darzizalol/eg1311-project/Matlab/Wheel Radius - Wheel Gap - Mass - Finish Time.png

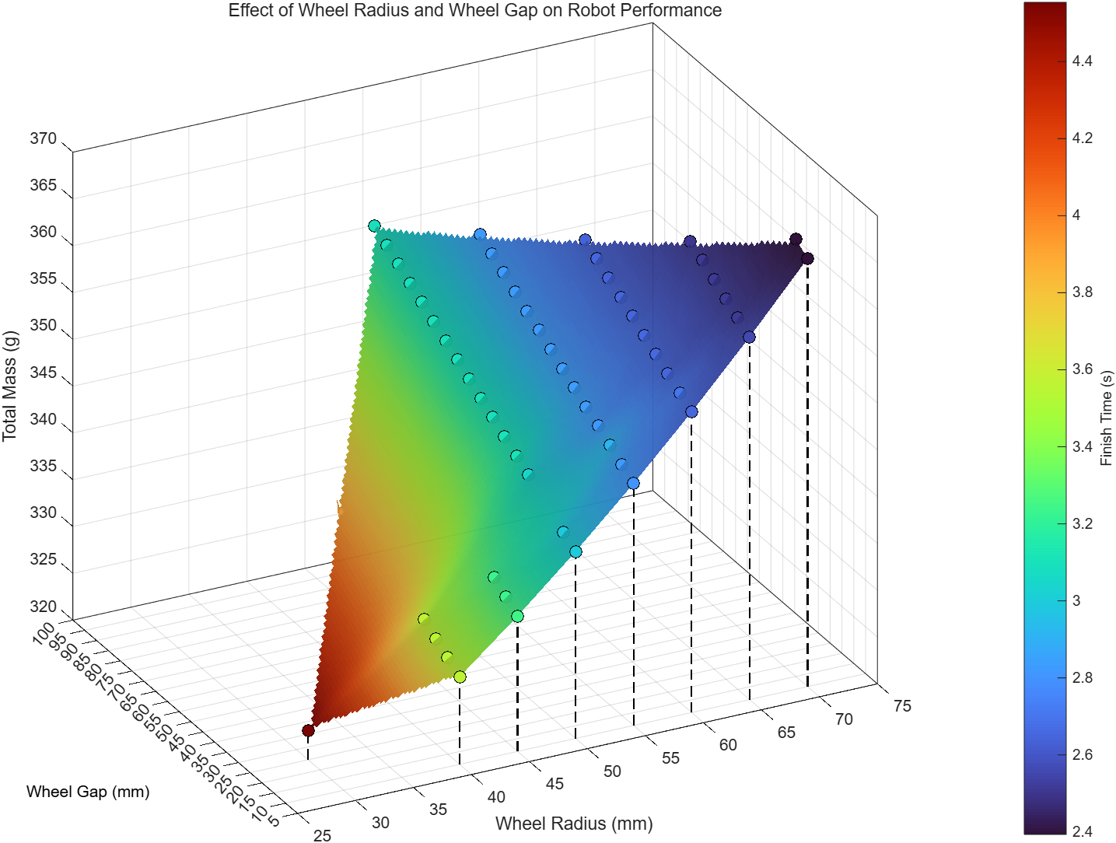
Matlab/Wheel Radius - Wheel Gap - Mass - Finish Time.png
