darzizalol/eg1311-project/Fusion360/Ping Pang Box Methods.md

Method 1: Masu Box
https://in.pinterest.com/pin/652670171034580377/

Method 2: Strong Box
https://www.youtube.com/watch?v=Zg081nhLKPg

√ Method 3: storage box
https://www.bilibili.com/video/BV1s34y1m7d1/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
