darzizalol/eg1311-project/2D CAD Drawings/Ball Basket Drawing.png

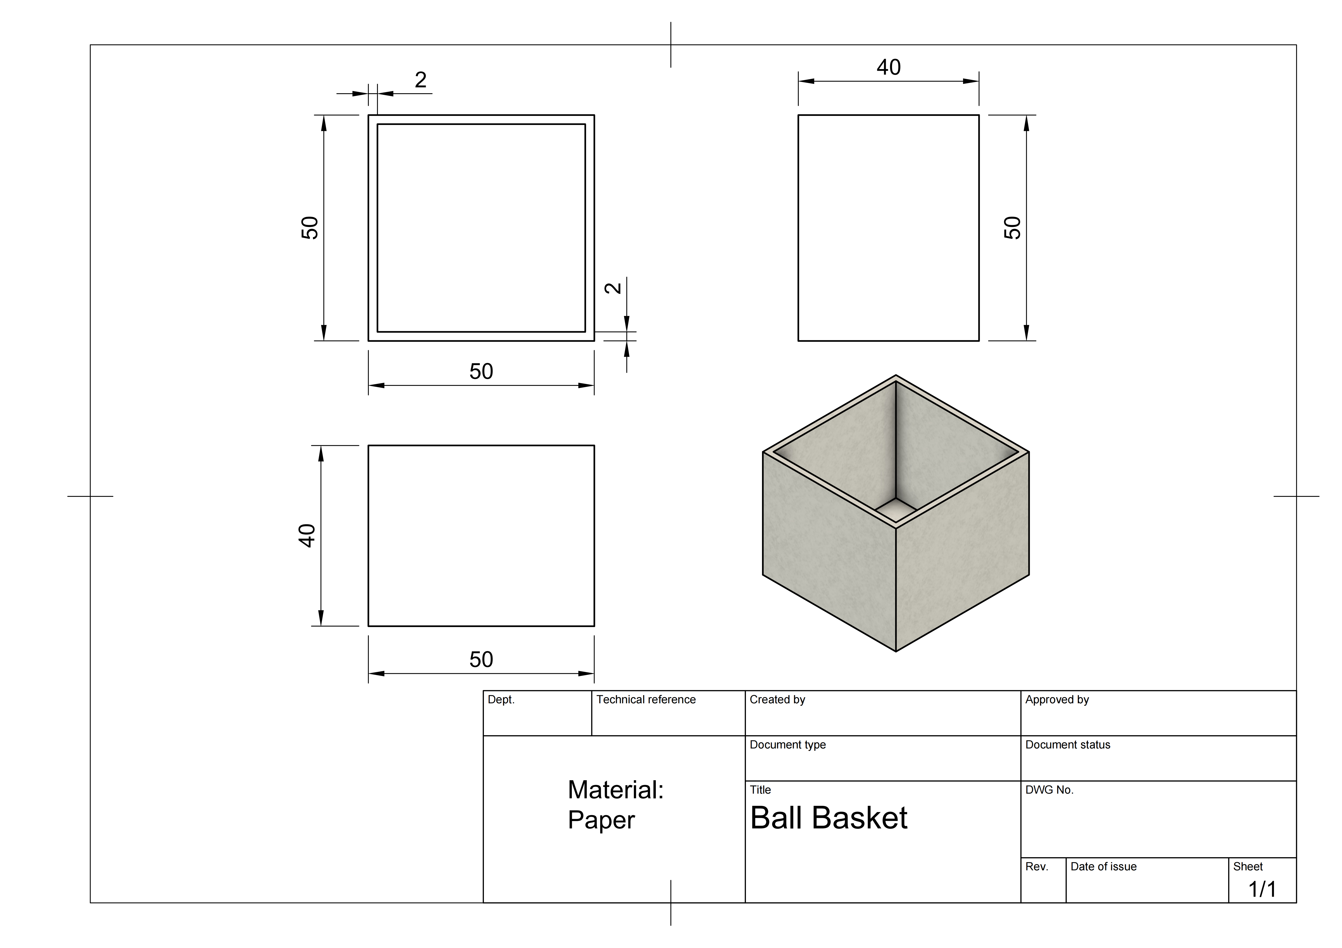
2D CAD Drawings/Ball Basket Drawing.png
