darzizalol/eg1311-project/2D CAD Drawings/Body Drawing.png

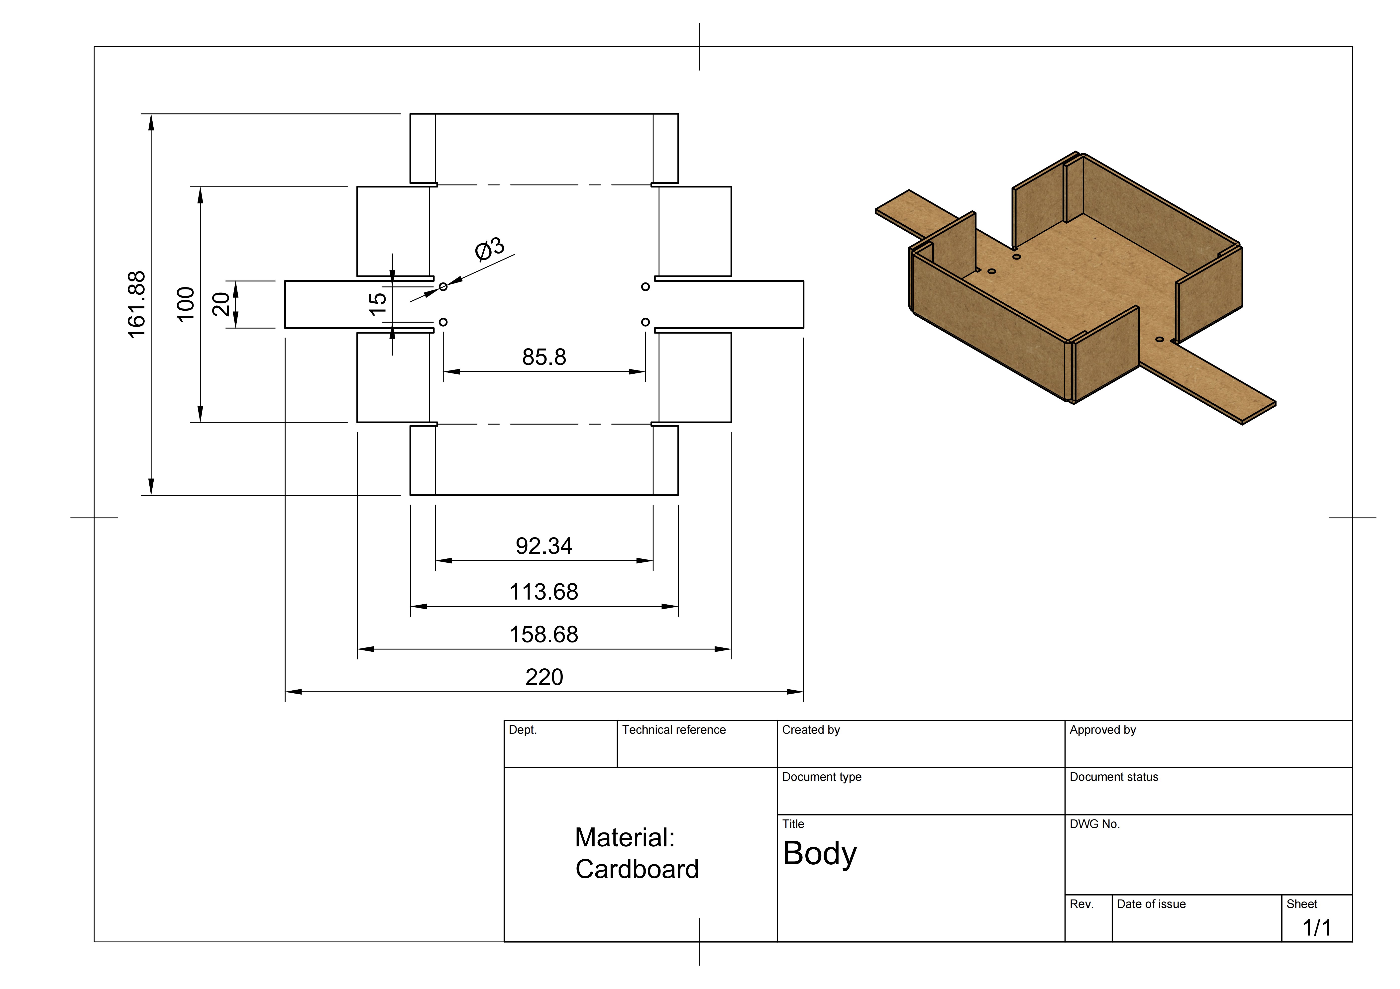
2D CAD Drawings/Body Drawing.png
