darzizalol/eg1311-project/2D CAD Drawings/Wheel Drawing.png

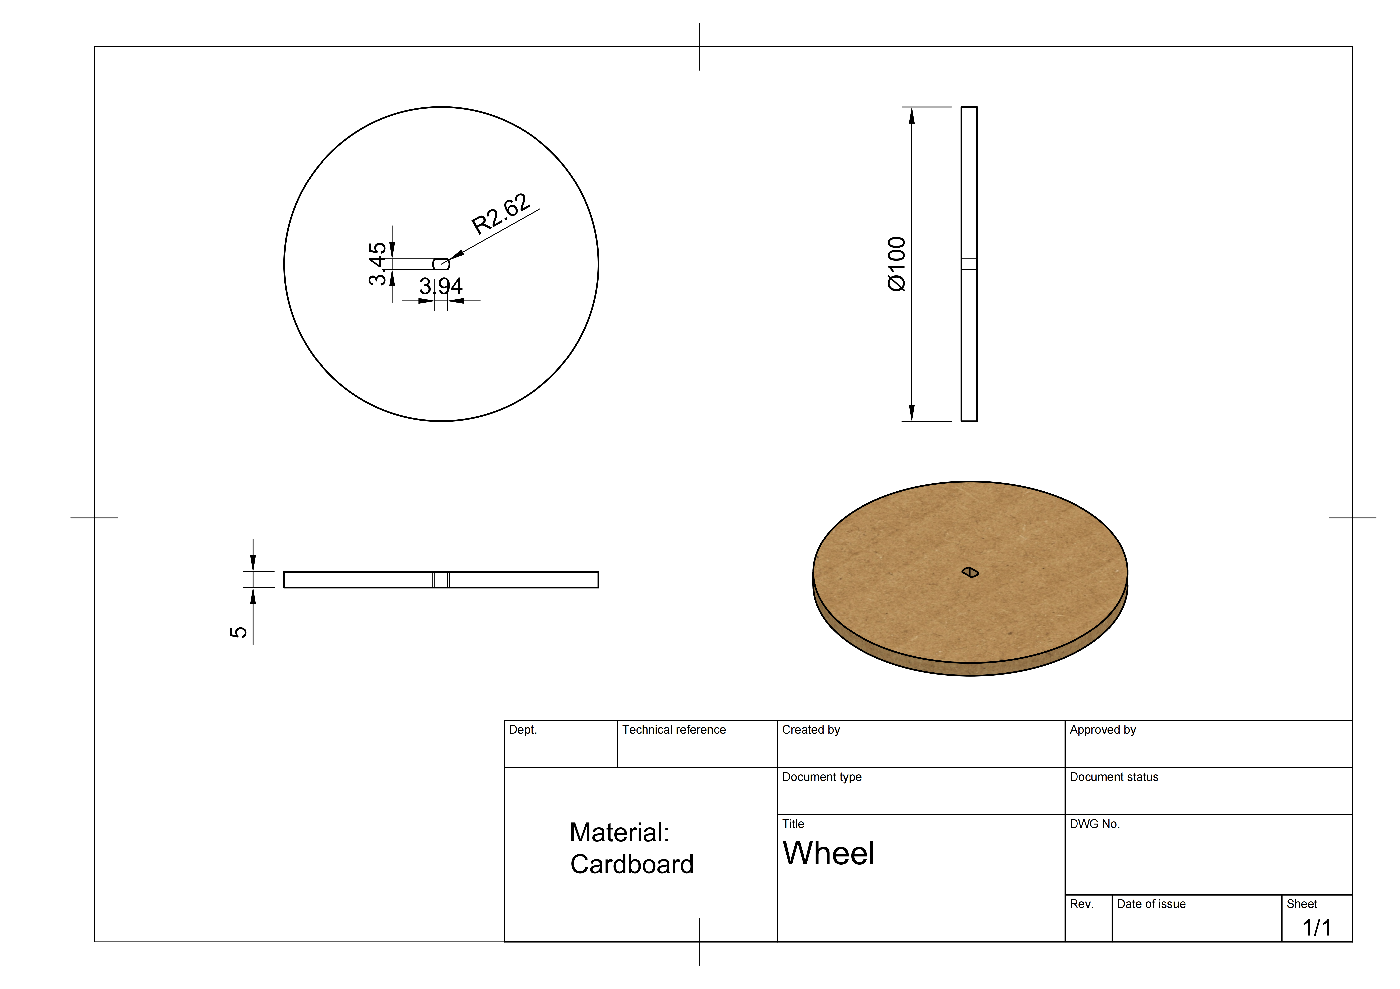
2D CAD Drawings/Wheel Drawing.png
