darzizalol/eg1311-project/Arduino/Arduino Code.png

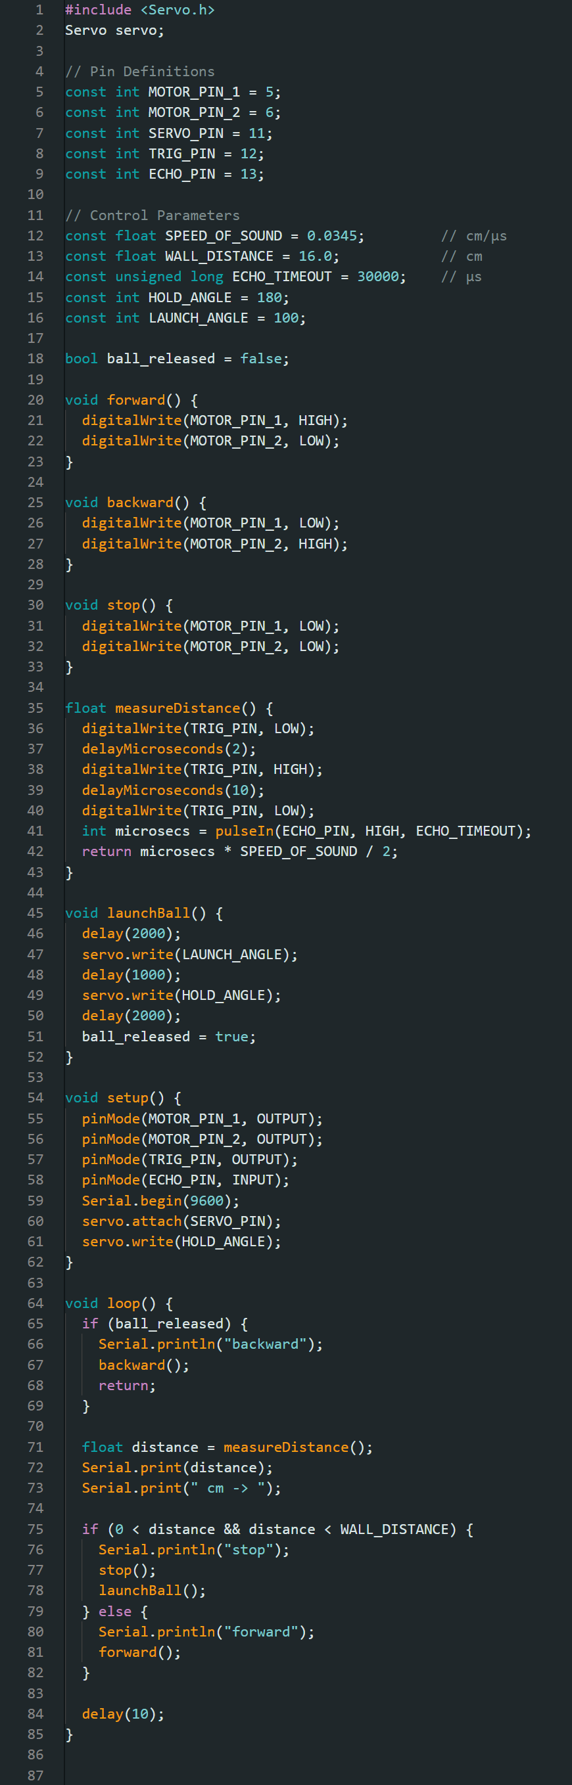
Arduino/Arduino Code.png
