darzizalol/eg1311-project/Arduino/tinkercad v1.png

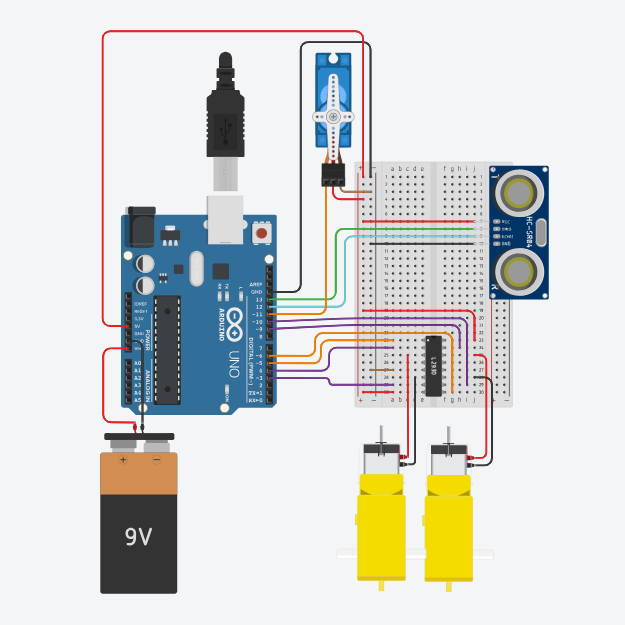
Arduino/tinkercad v1.png
