darzizalol/eg1311-project/Arduino/tinkercad v2.png

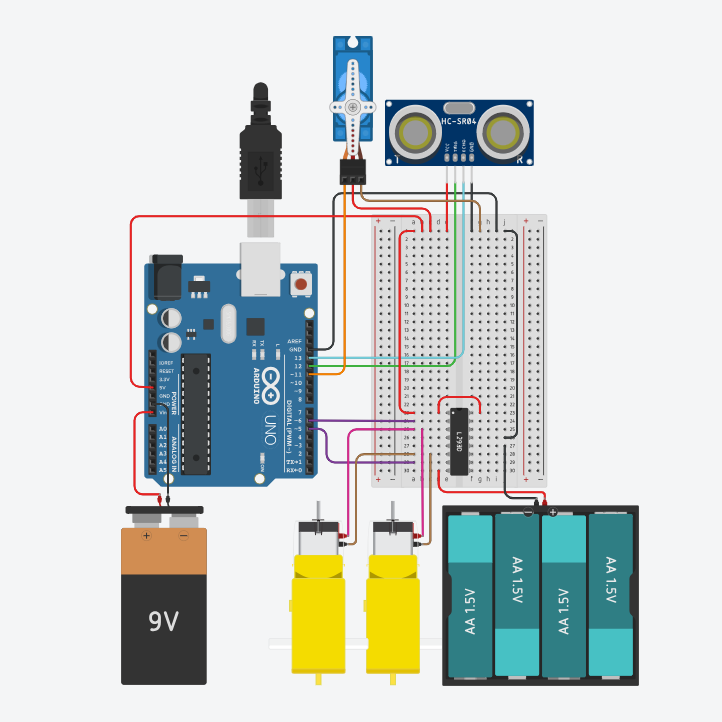
Arduino/tinkercad v2.png
