darzizalol/eg1311-project/Arduino/图片1.png

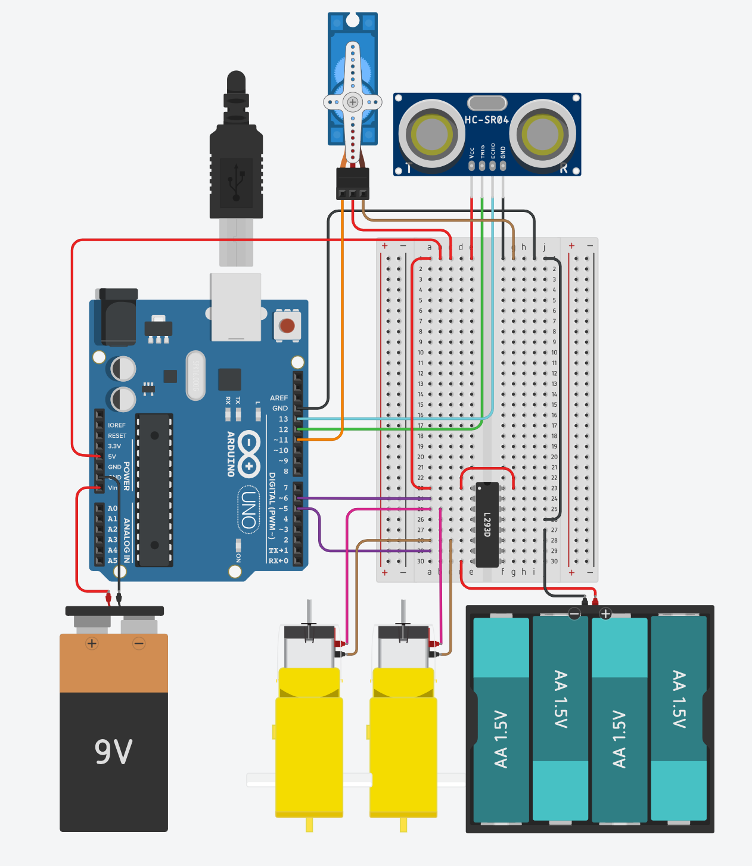
Arduino/图片1.png
