darzizalol/eg1311-project/Fusion360/Render_Front_Side.png

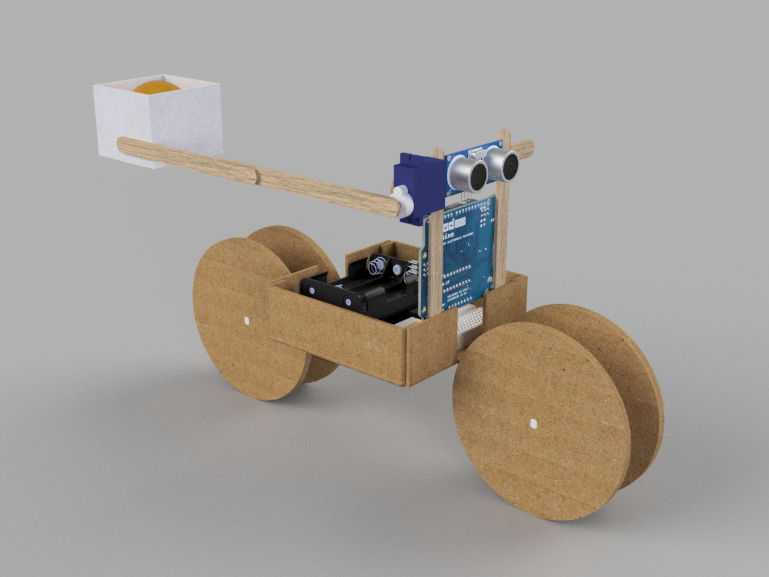
Fusion360/Render_Front_Side.png
