darzizalol/eg1311-project/Fusion360/Render_Rear_Side.png

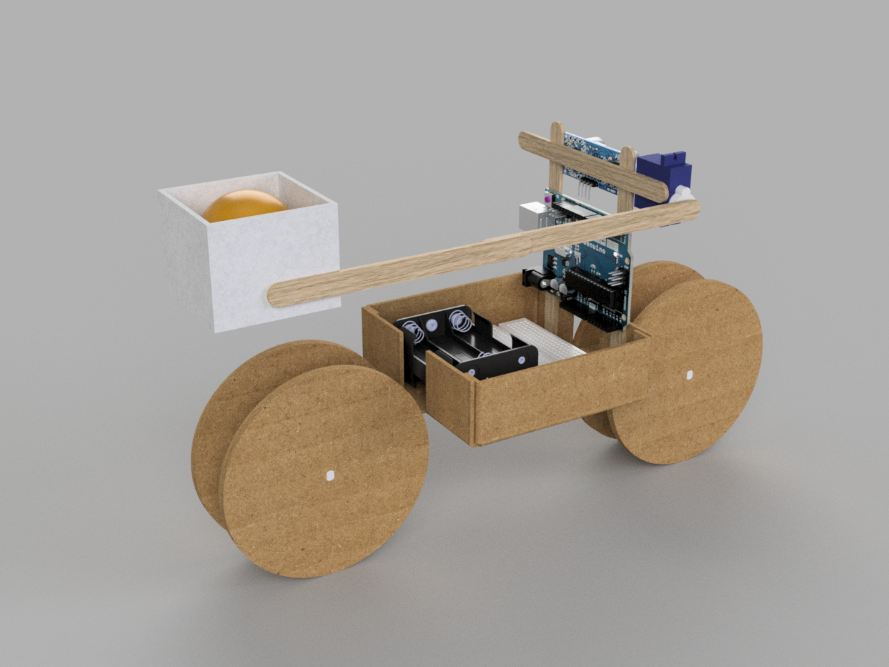
Fusion360/Render_Rear_Side.png
