darzizalol/eg1311-project/Matlab/Simulink Block Diagram.png

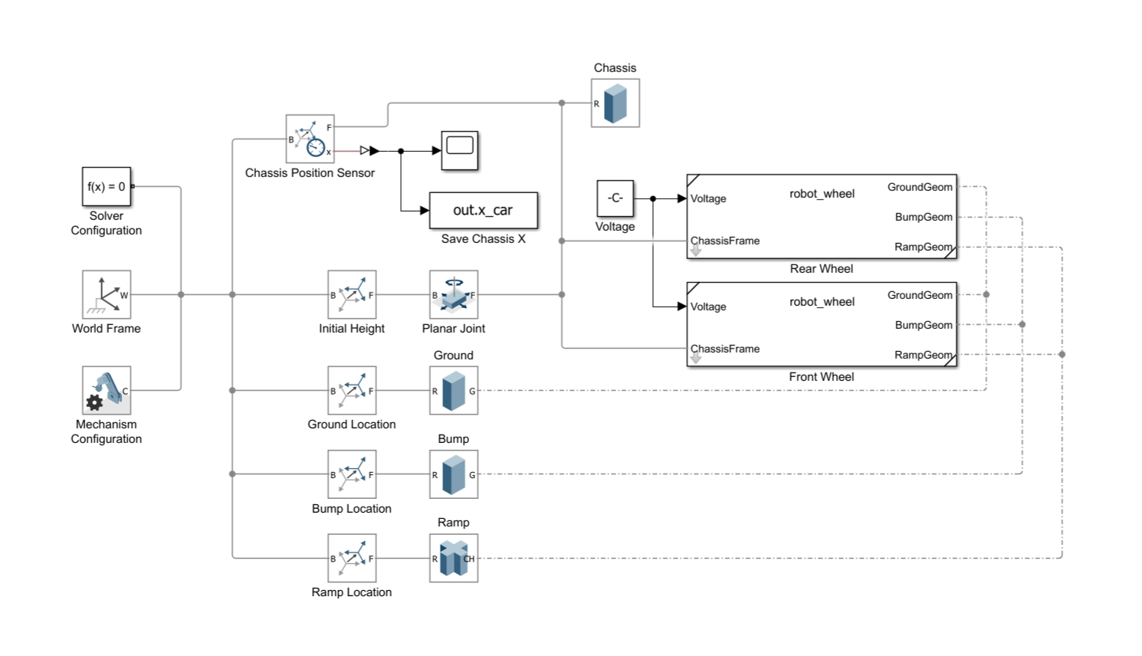
Matlab/Simulink Block Diagram.png
