darzizalol/eg1311-project/(list of files, cad)

Other CAD files:
Fusion360/Assembly.f3z
