darzizalol/eg1311-project/2D CAD Drawings/Assembly Drawing.png

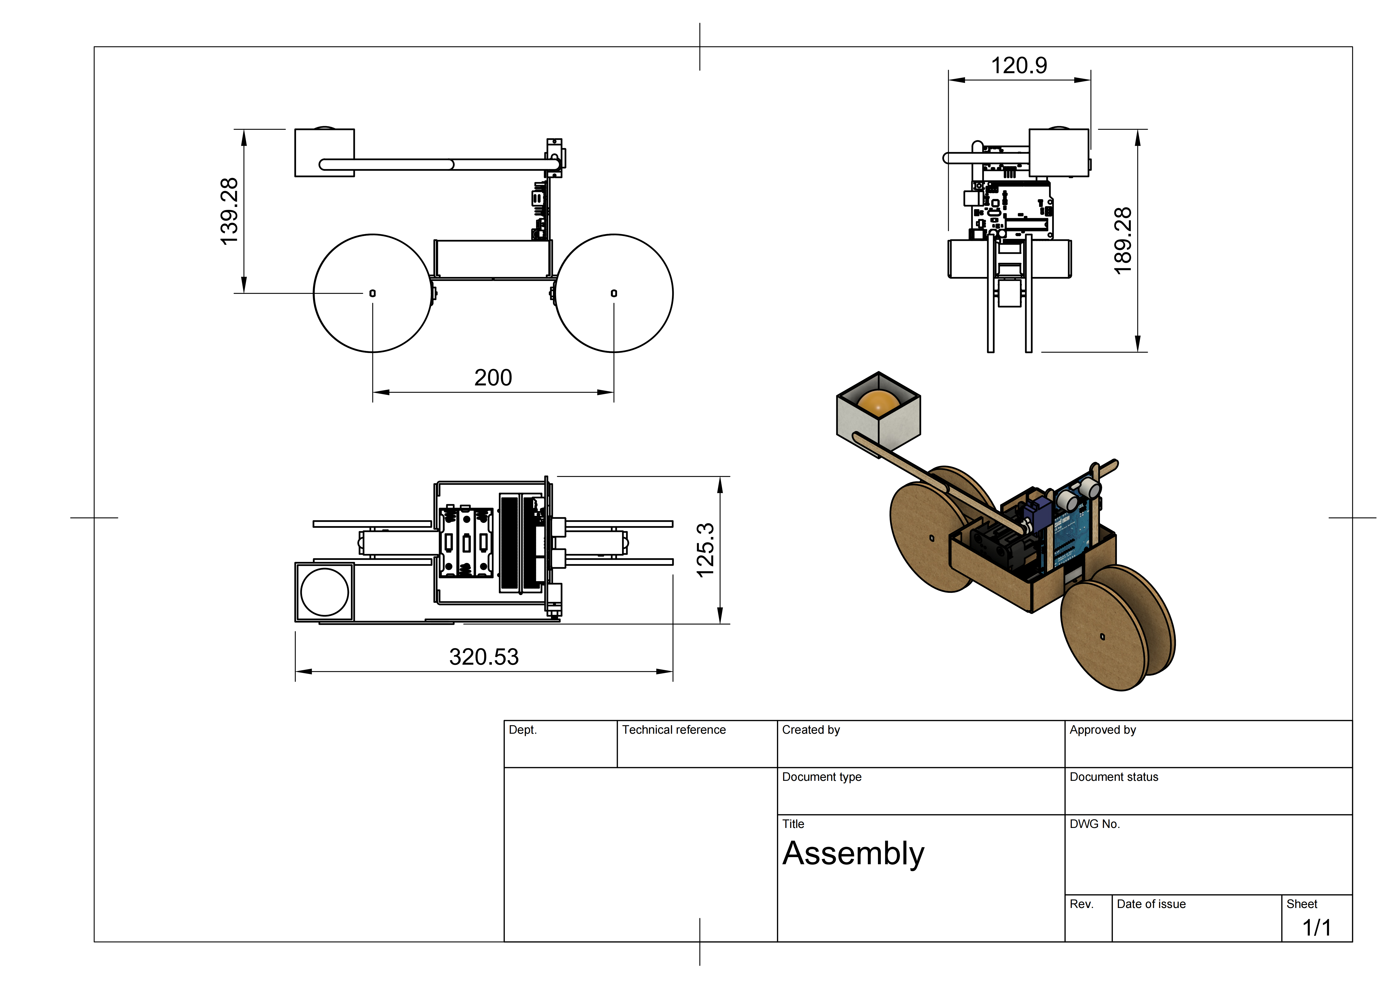
2D CAD Drawings/Assembly Drawing.png
