darzizalol/eg1311-project/2D CAD Drawings/Sensor Assembly Drawing.png

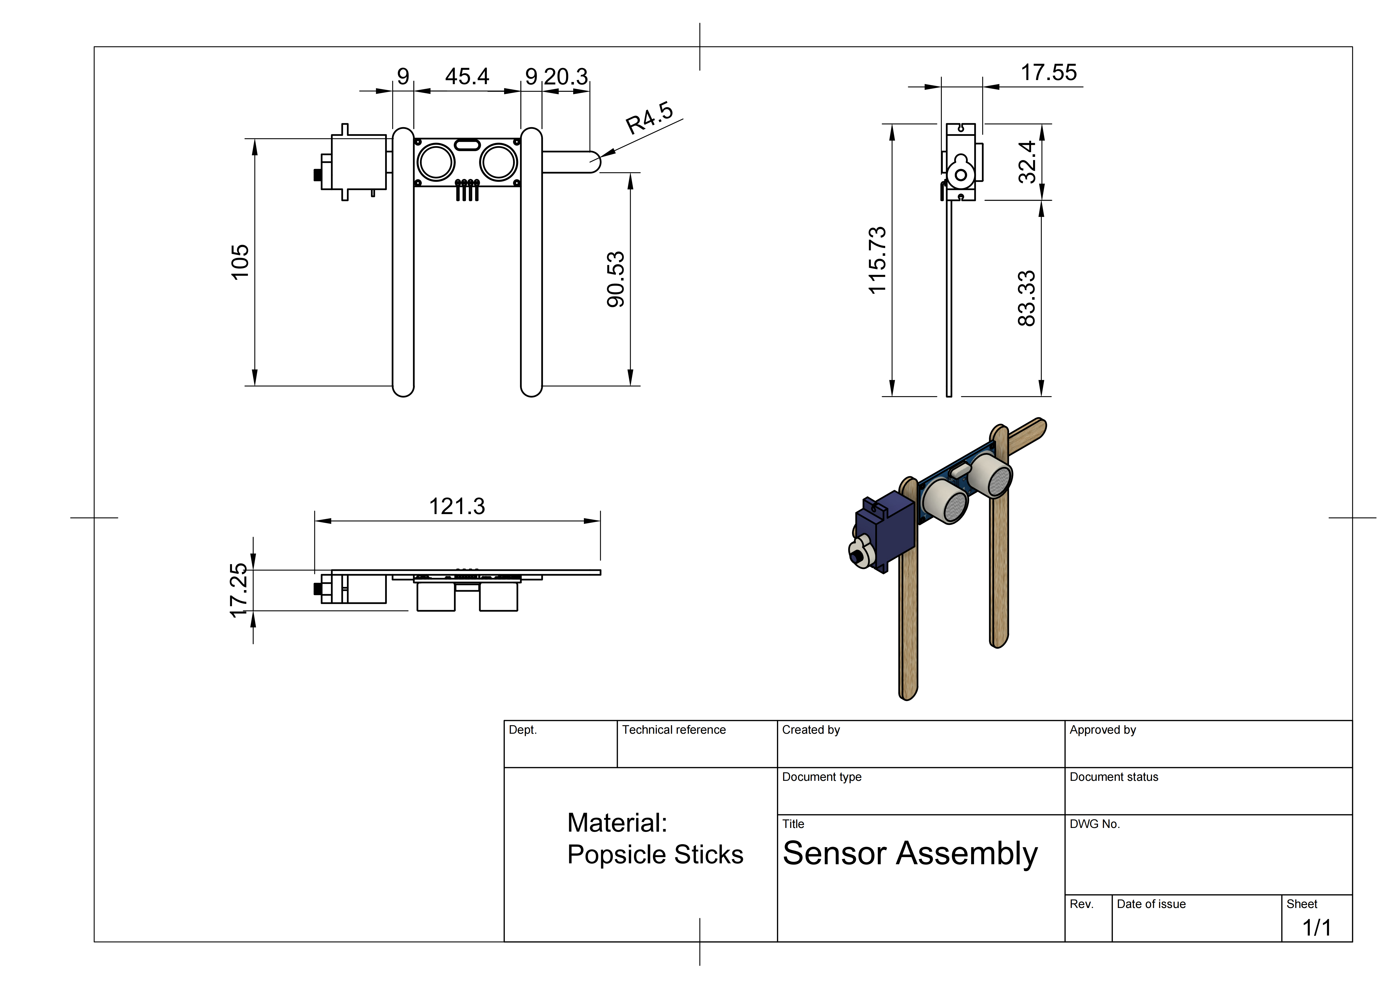
2D CAD Drawings/Sensor Assembly Drawing.png
