darzizalol/eg1311-project/2D CAD Drawings/Assembly Rear Drawing.pdf

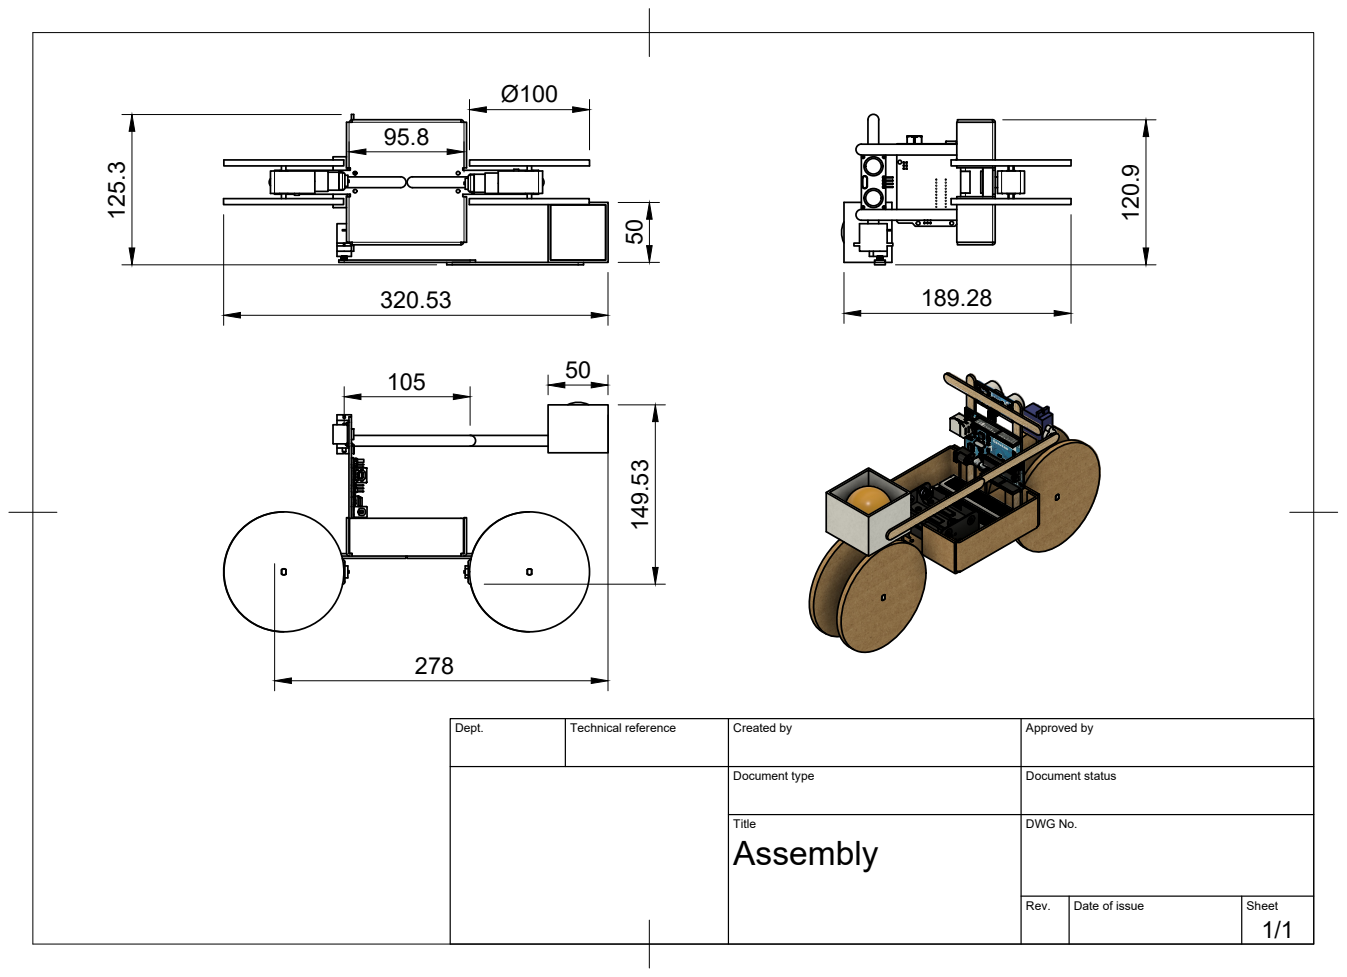
[picture p15: page 1]

Dept. | Technical reference | Created by | Approved by

Document type | Document status

Title Assembly | DWG No.

Rev. | Date of issue | Sheet 1/1
