darzizalol/eg1311-project/2D CAD Drawings/Sensor Assembly Drawing.pdf

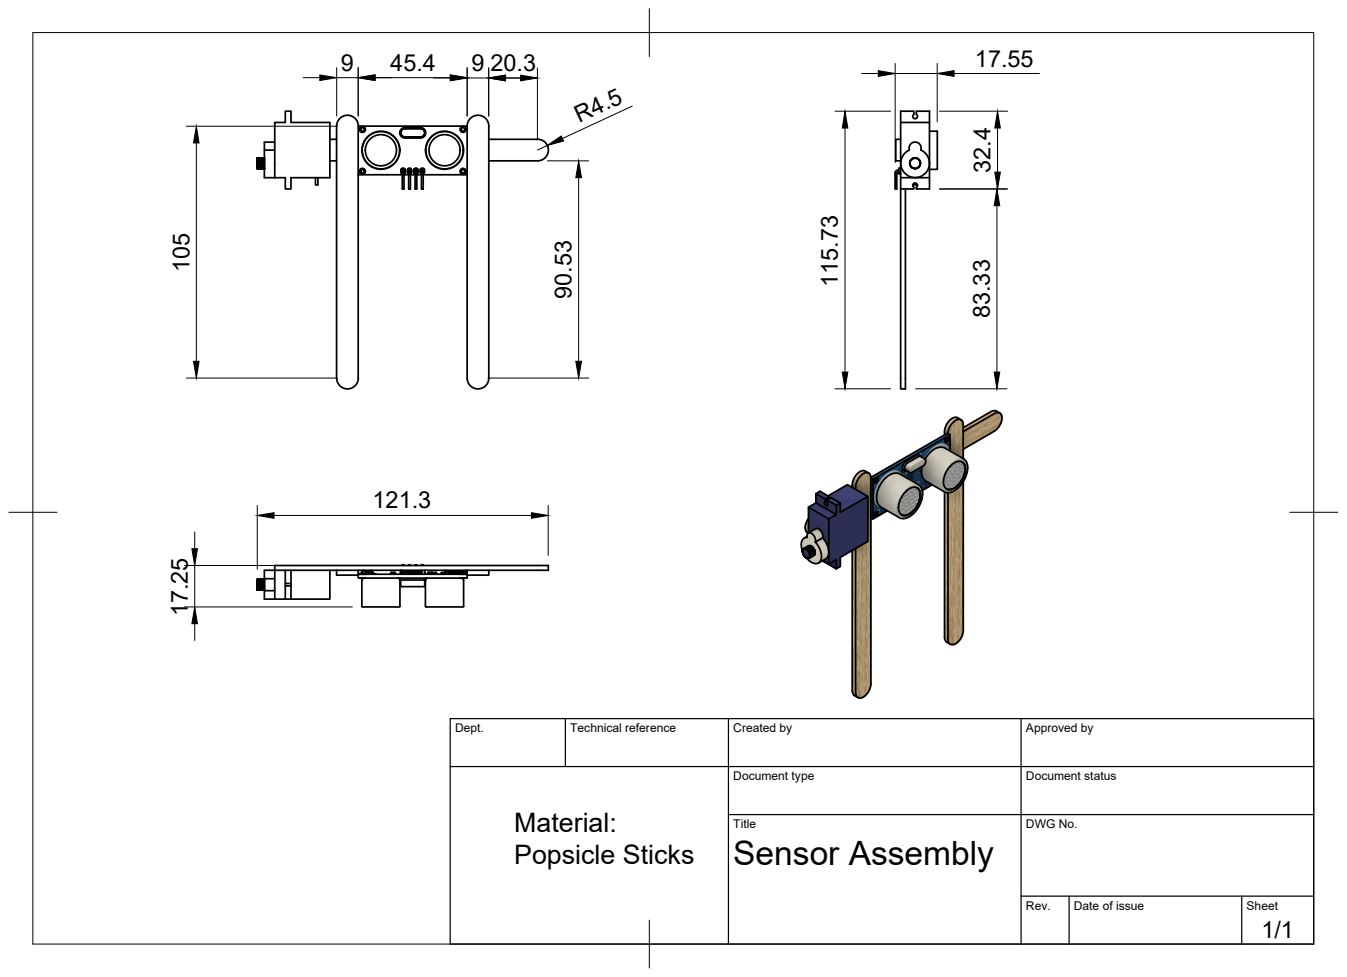
[picture p16: page 1]
Sensor Assembly 115.73; Popsicle Sticks

Dept. | Technical reference | Created by | Approved by

Material: | | Document type | Document status

Title | DWG No.

Rev. | Date of issue | Sheet 1/1
