darzizalol/eg1311-project/Body Drawing.pdf

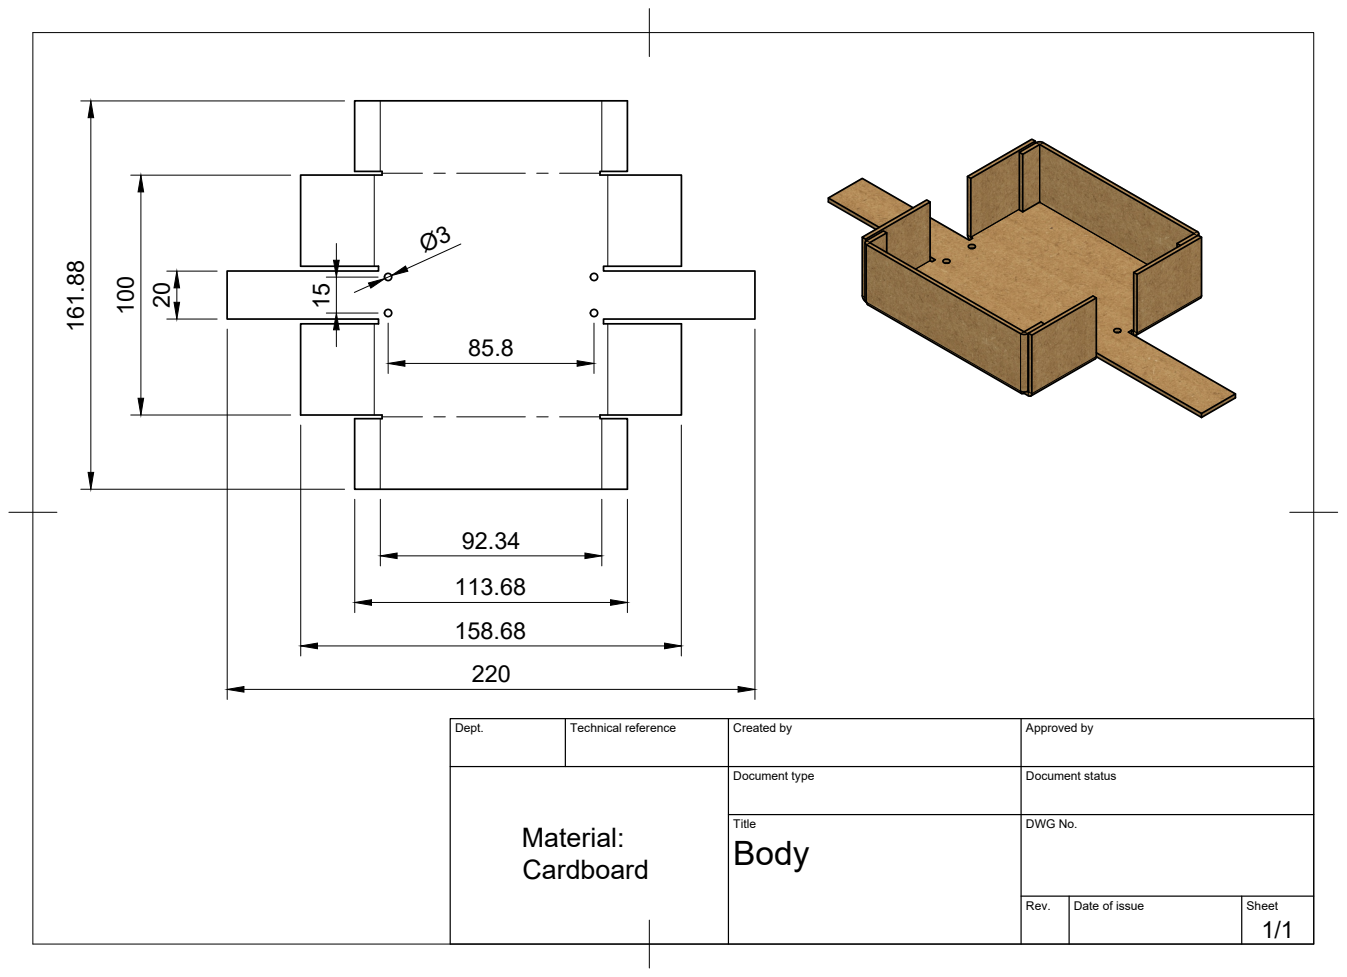
[picture p17: page 1]

Dept. | Technical reference | Created by | Approved by

Cardboard | | Document type Body Material: | Document status

Title | DWG No.

Rev. | Date of issue | Sheet 1/1
