darzizalol/eg1311-project/2D CAD Drawings/Ball Basket Drawing.pdf

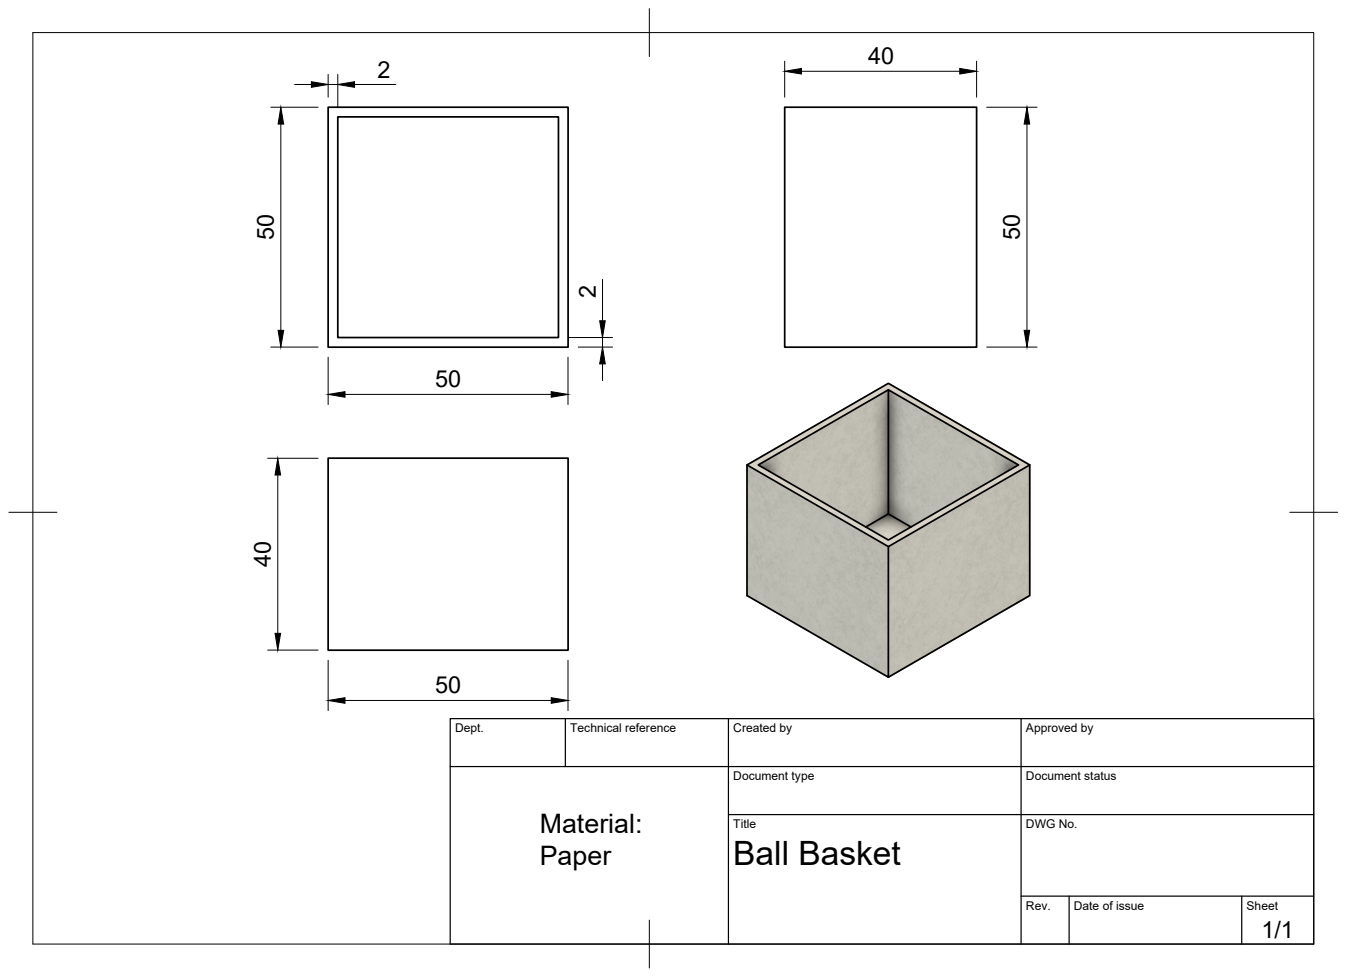
[picture p18: page 1]

Dept. | Technical reference | Created by | Approved by

Material: Paper | | Document type | Document status

Title Ball Basket | DWG No.

Rev. | Date of issue | Sheet 1/1
