darzizalol/eg1311-project/2D CAD Drawings/Wheel Drawing.pdf

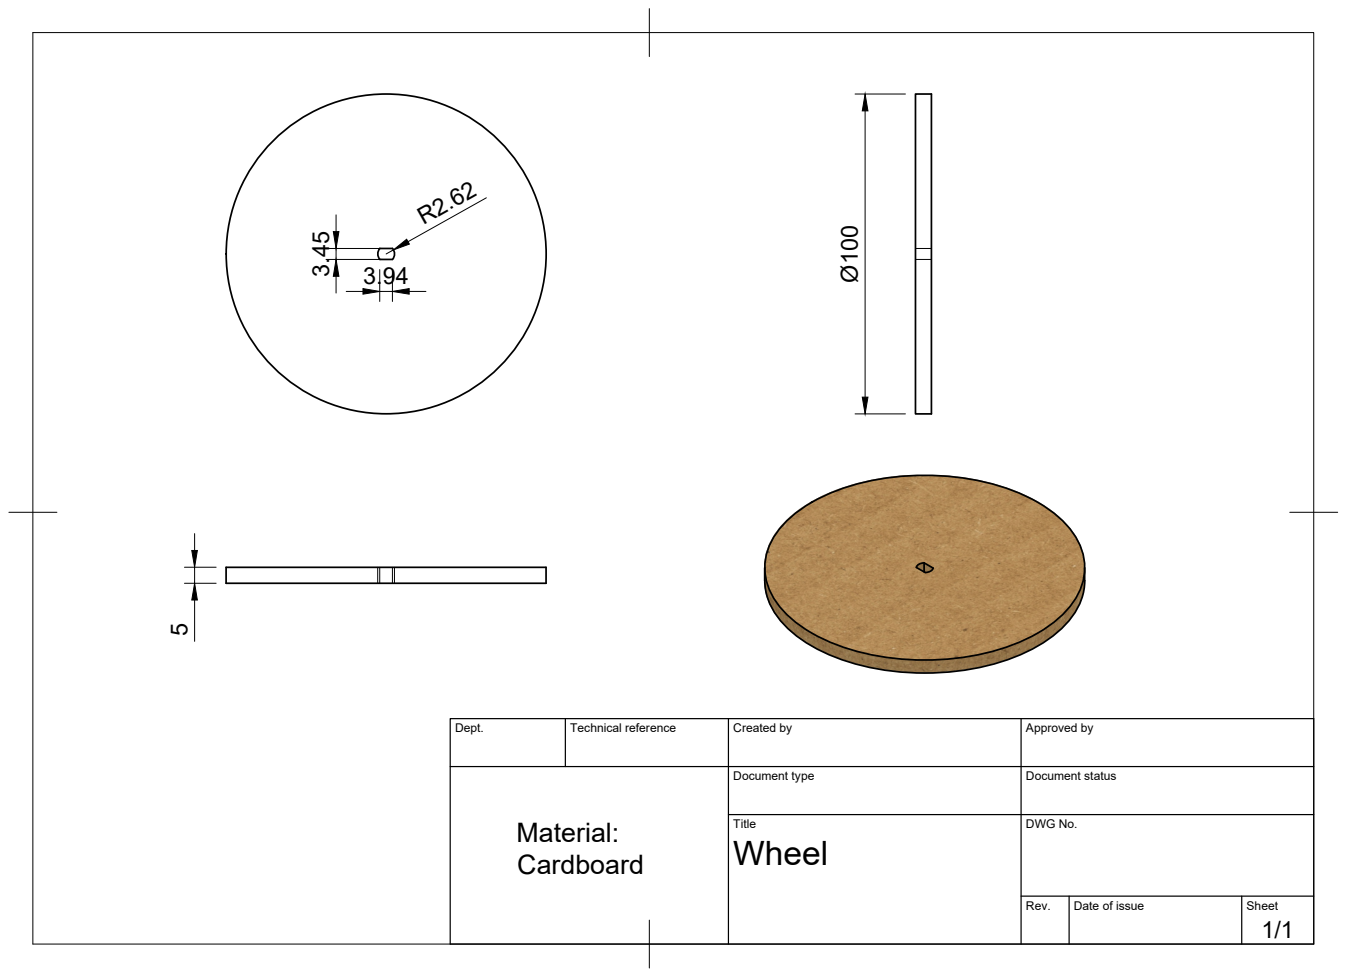
[picture p19: page 1]

Dept. | Technical reference | Created by | Approved by

Material: Cardboard | | Document type | Document status

Title Wheel | DWG No.

Rev. | Date of issue | Sheet 1/1
