darzizalol/eg1311-project/Fusion360/Robot Assembly v1.pdf

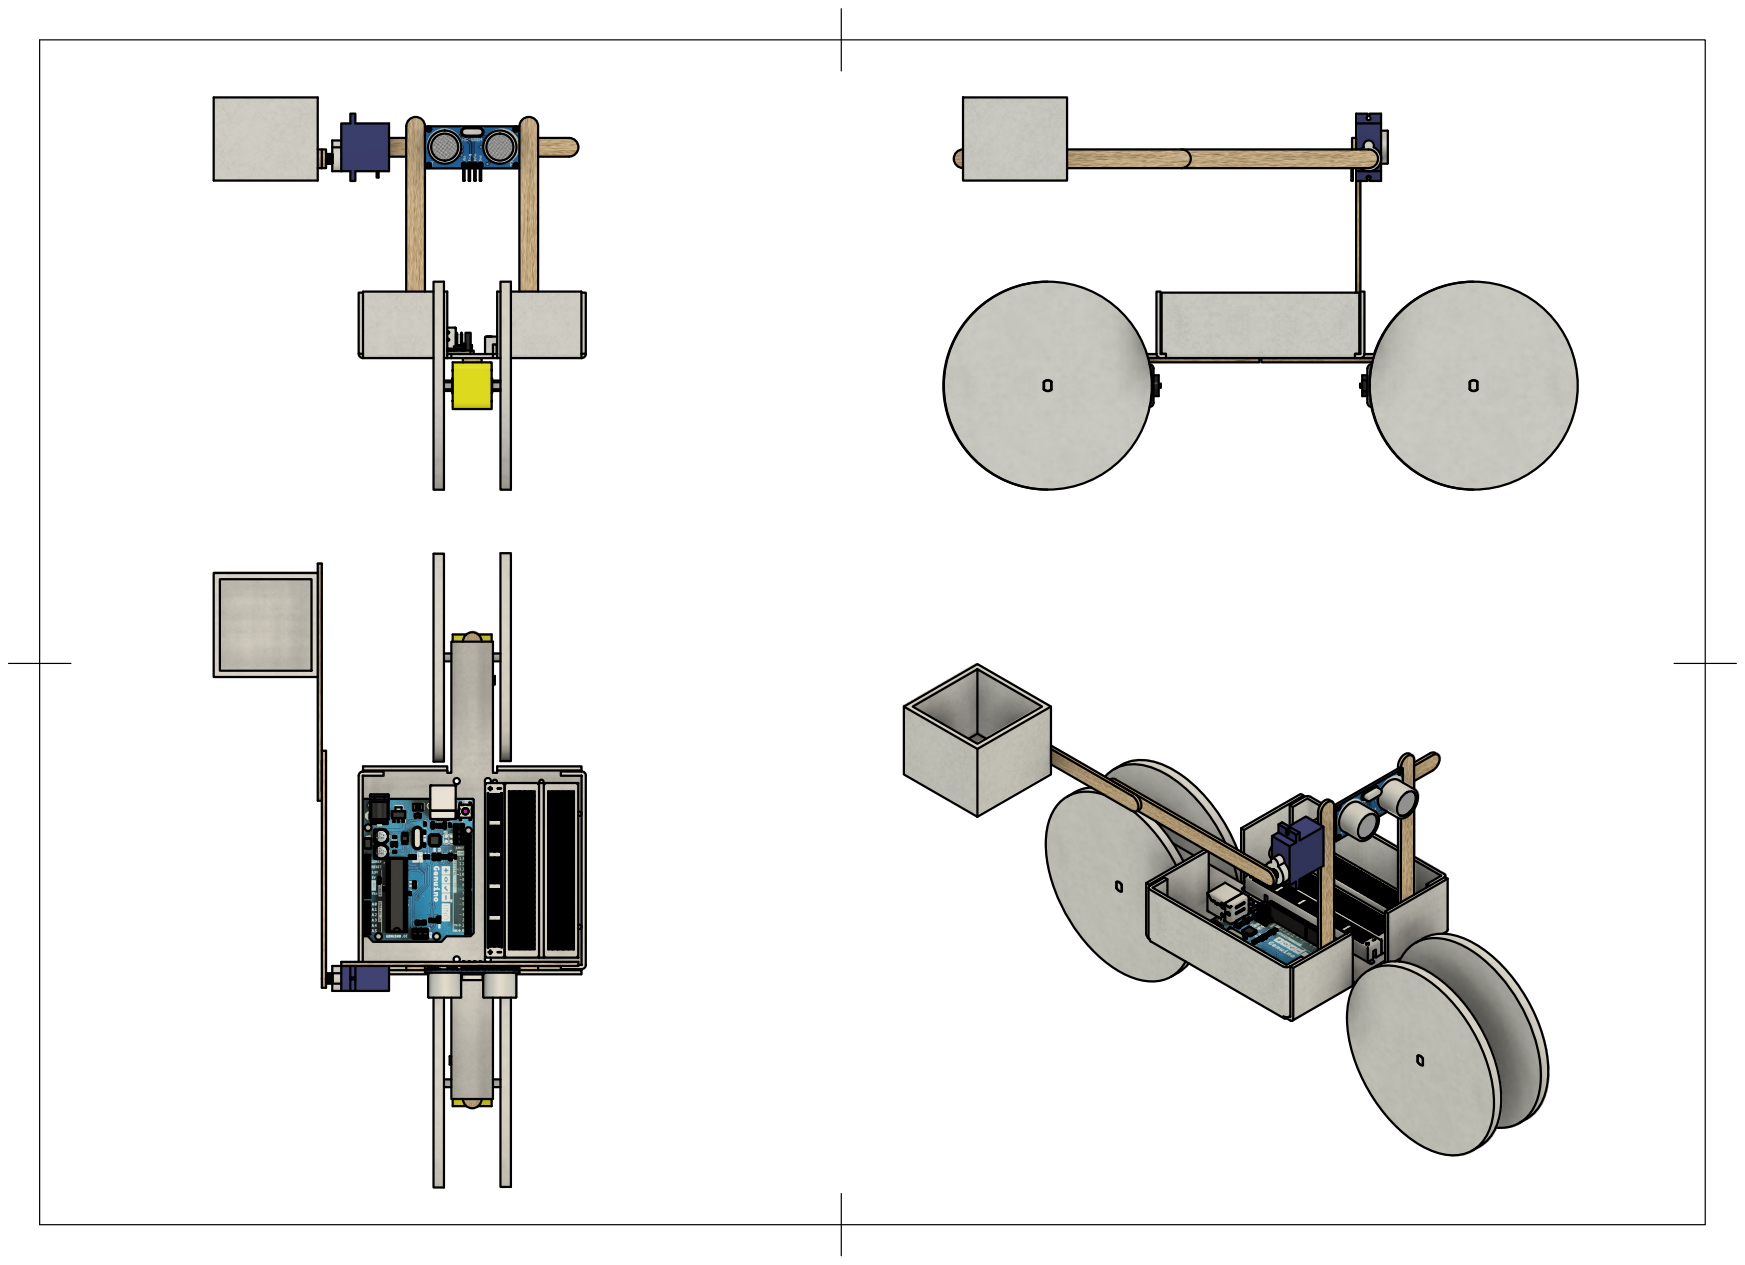
[picture p20: page 1]
