darzizalol/eg1311-project/Fusion360/Final Body Template.pdf

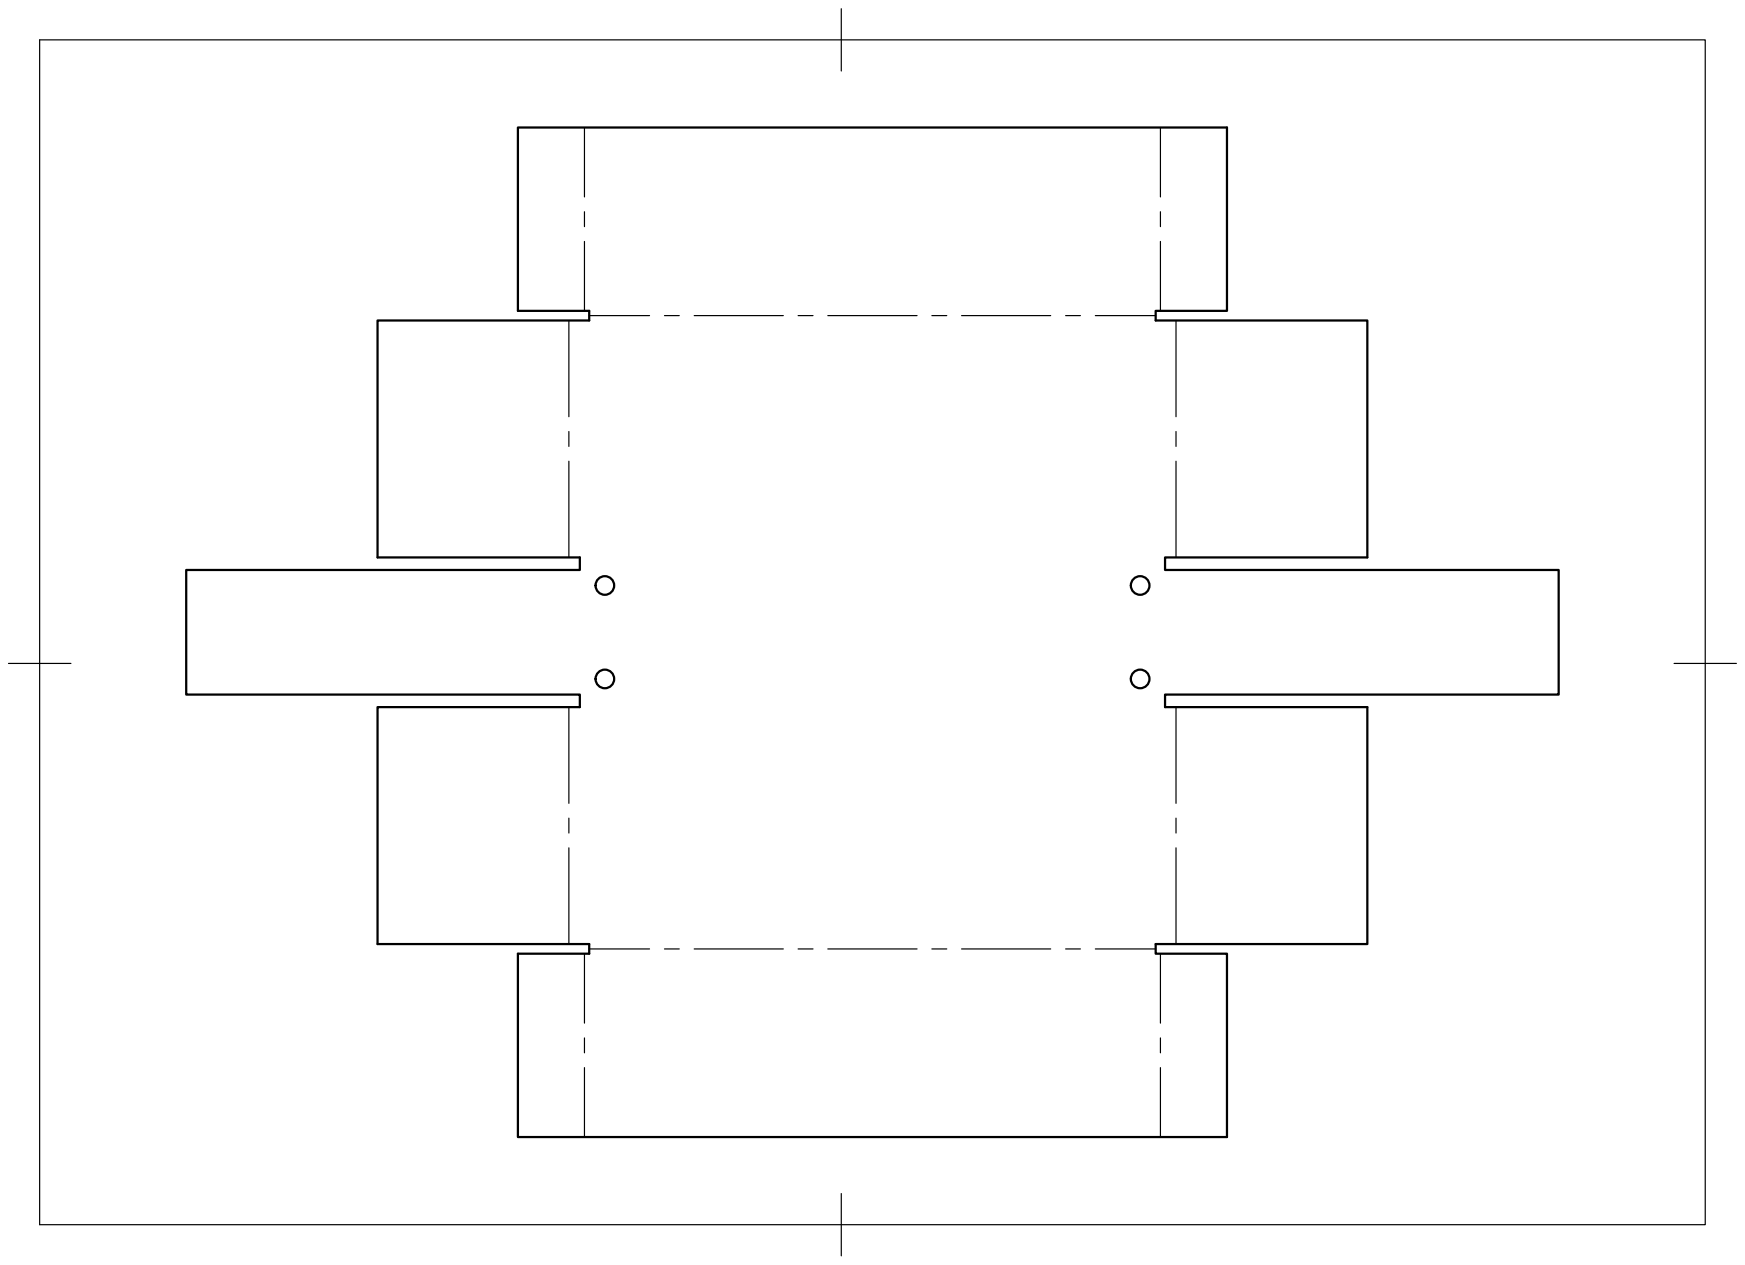
[picture p21: page 1]
