darzizalol/eg1311-project/Fusion360/Final Wheel Template.pdf

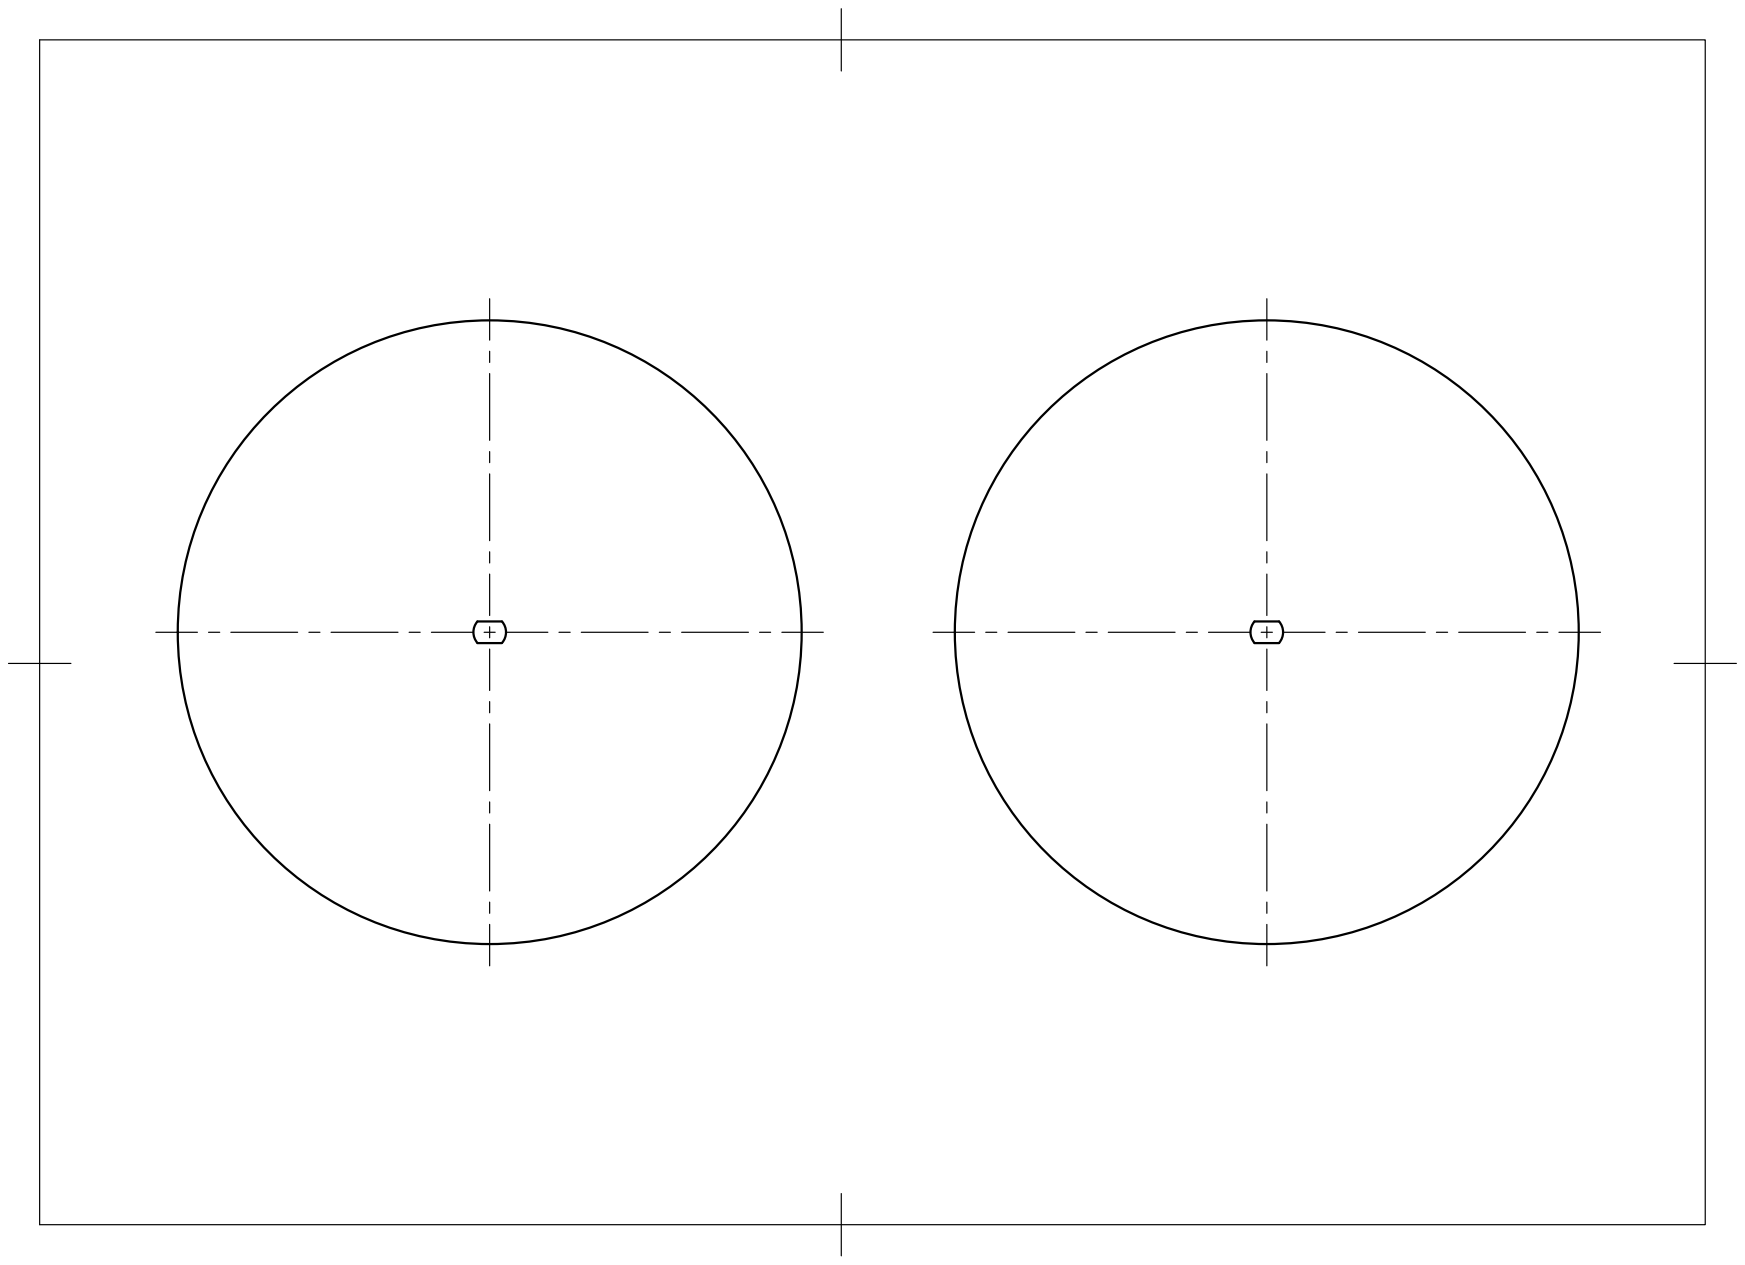
[picture p22: page 1]
