darzizalol/eg1311-project/Fusion360/Base Cardboard Template v2.pdf

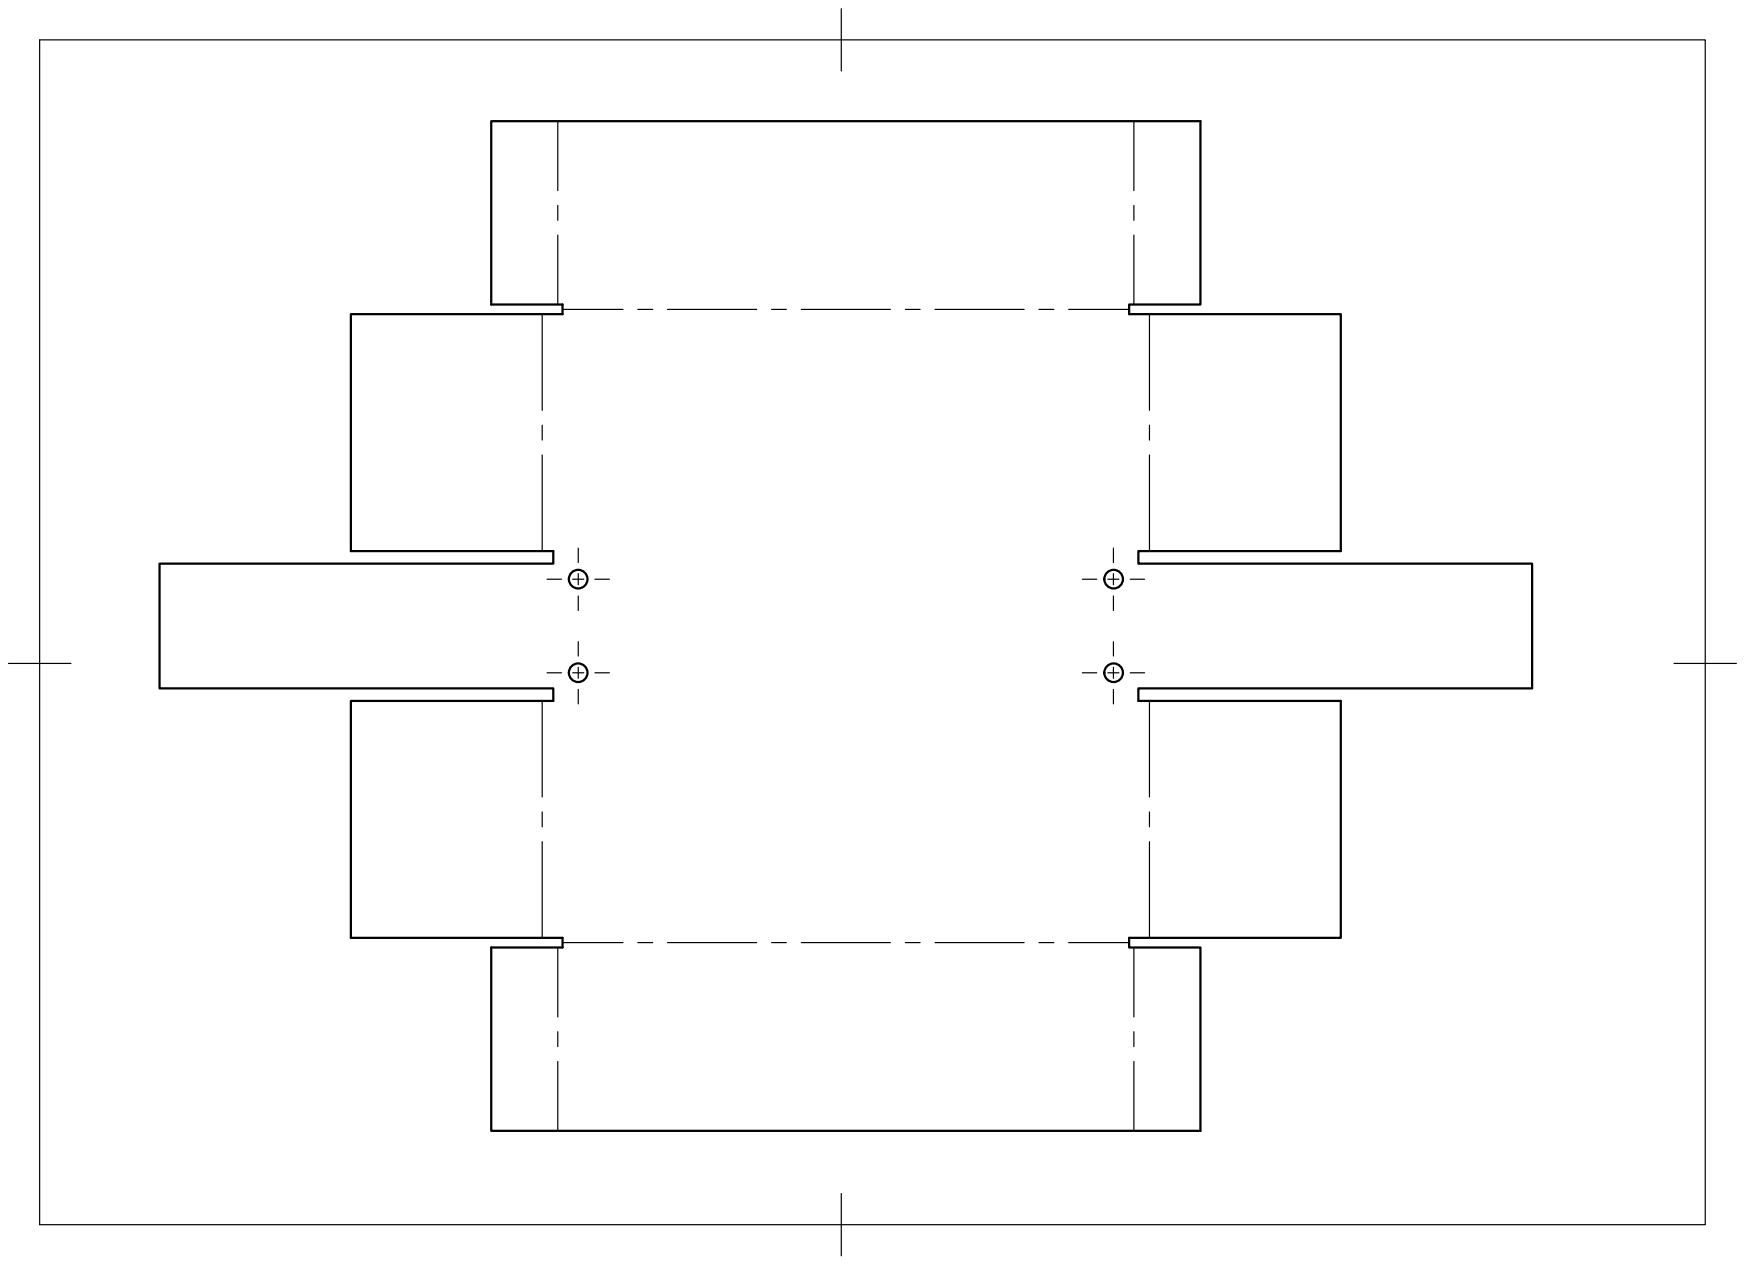
[picture p23: page 1]
