darzizalol/eg1311-project/Fusion360/Wheel Cardboard Template.pdf

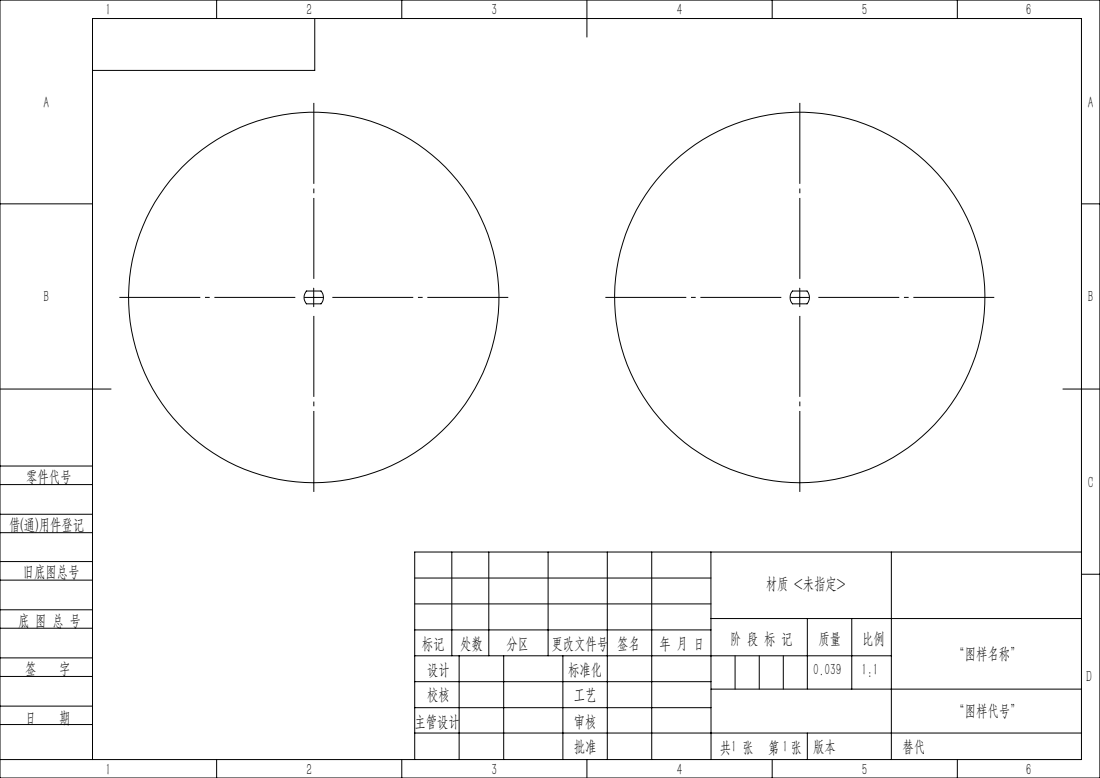
[picture p24: page 1]

材质 <未指定>

阶 段 标 记 | 质量 | 比例 | “图样名称”

标记 | 处数 | 分区 | 更改文件号 | 签名 | 年 月 日

“图样代号”
