darzizalol/eg1311-project/Fusion360/Base Cardboard Template v1.pdf

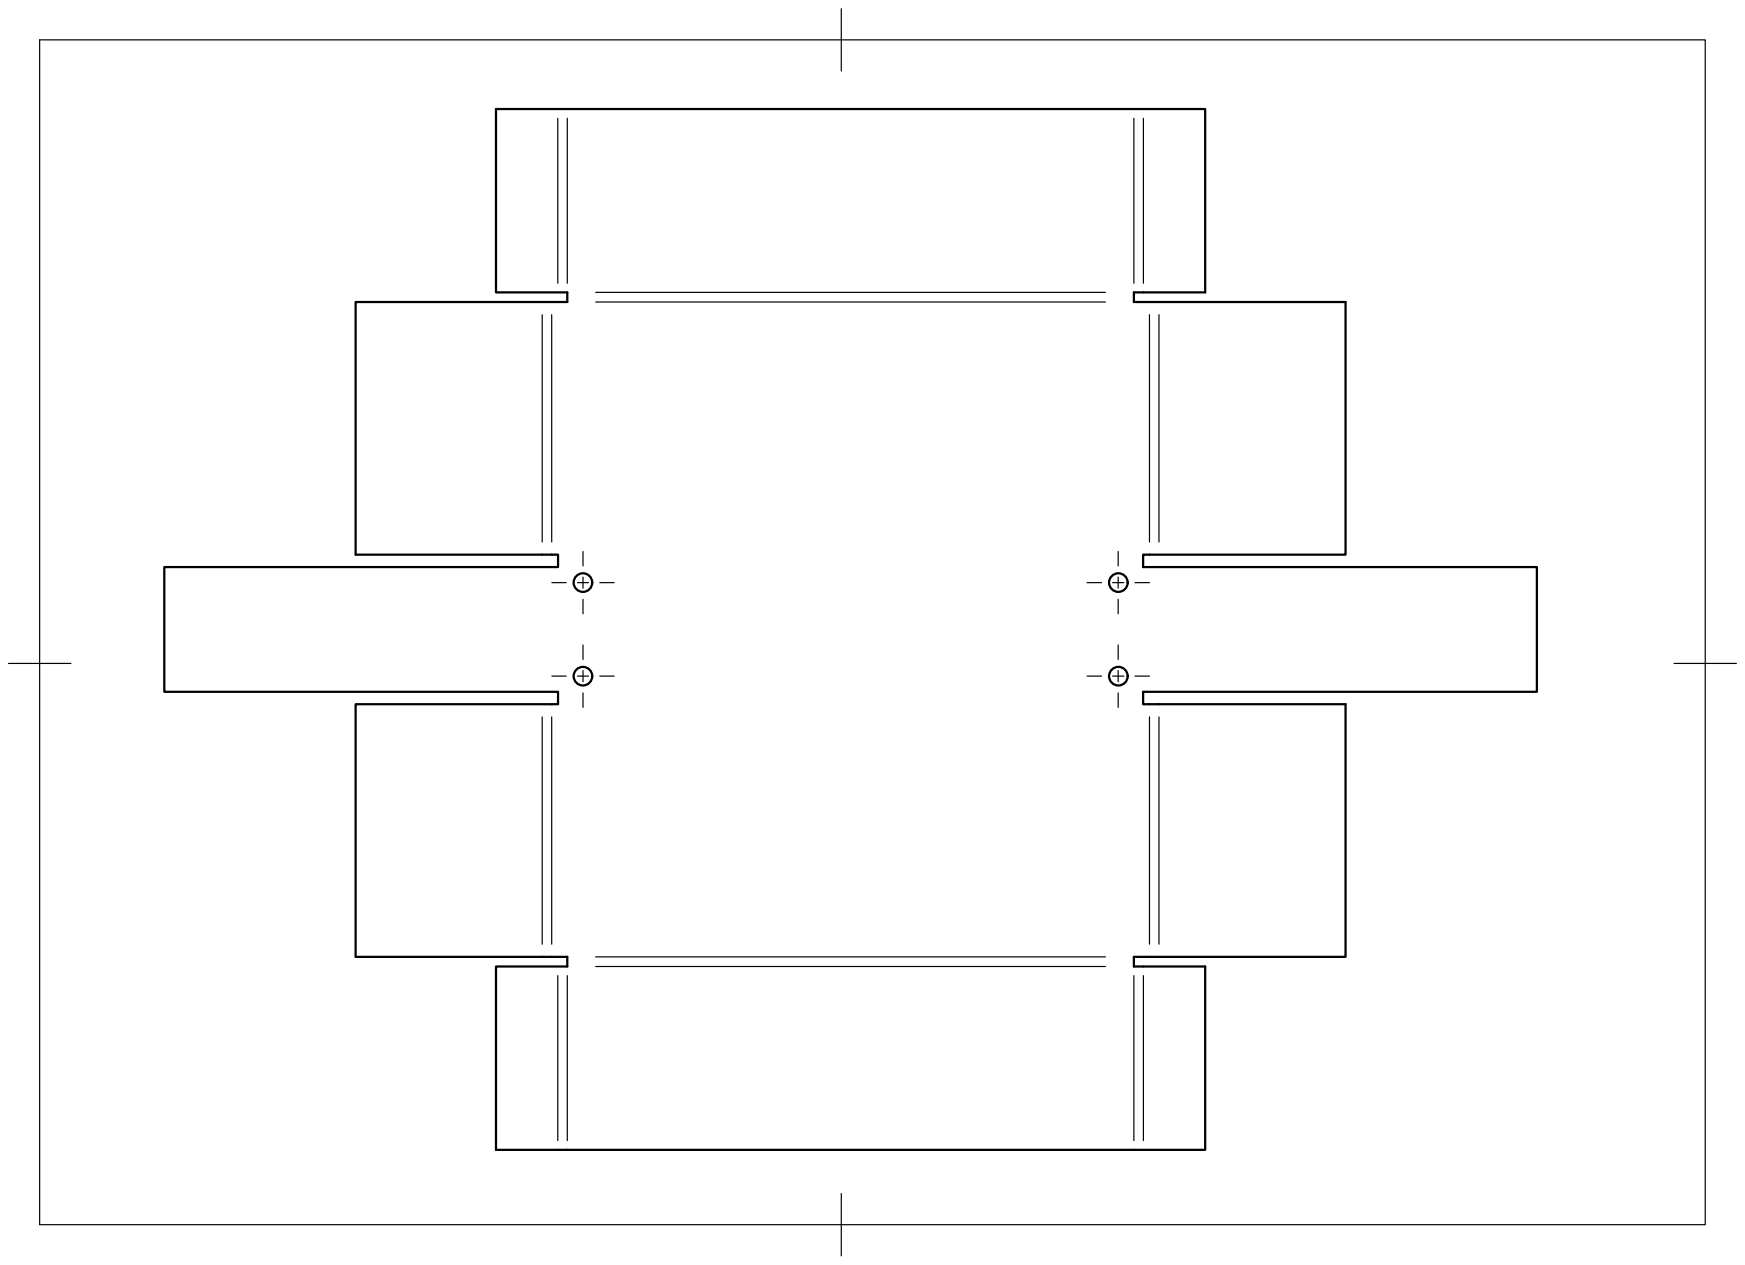
[picture p25: page 1]
