darzizalol/eg1311-project/(commit log)

2026-09-14 Rename Cardboar Wheel Template.pdf to Cardboard Wheel Template.pdf
2026-09-14 Rename Cardboard Wheel Template.pdf to Wheel Cardboard Template.pdf
2026-09-18 Rename Body 工程图.pdf to Base Cardboard Template v2.pdf
2026-09-19 Rename connection_diag.jpeg to Arduino/tinkercad v1.jpeg
2026-09-20 Rename Final_Project_Old.ino to Final_Project_Old (With Speed Calibration).ino
2026-09-20 Rename Final_Project_Old (With Speed Calibration).ino to Final_Project_Old (Speed Calibration).ino
2026-09-25 Insert image in README
    Added an image to the README file.
2026-10-27 Rename 图片1.png to tinkercad v2.png
2026-10-27 Rename Body Drawing.pdf to 2D CAD Drawings/Body Drawing.pdf
